moustapha2394/RobotArm/Ressources/HEW-DV4 a lasercut desktop robot arm - 4637503/images/SimpGrip_range_low_res.jpg

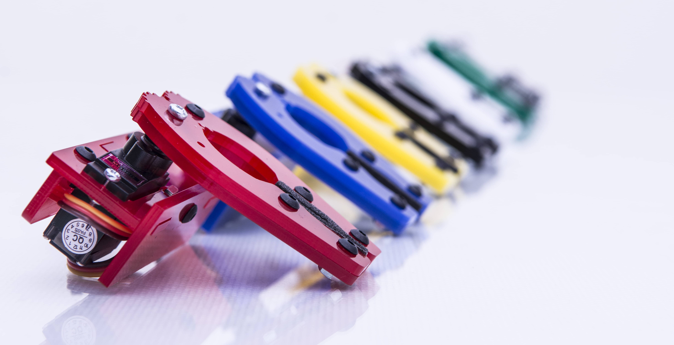
Ressources/HEW-DV4 a lasercut desktop robot arm - 4637503/images/SimpGrip_range_low_res.jpg
