moustapha2394/RobotArm/Ressources/HEW-DV4 a lasercut desktop robot arm - 4637503/images/IMG_1207-min.JPG

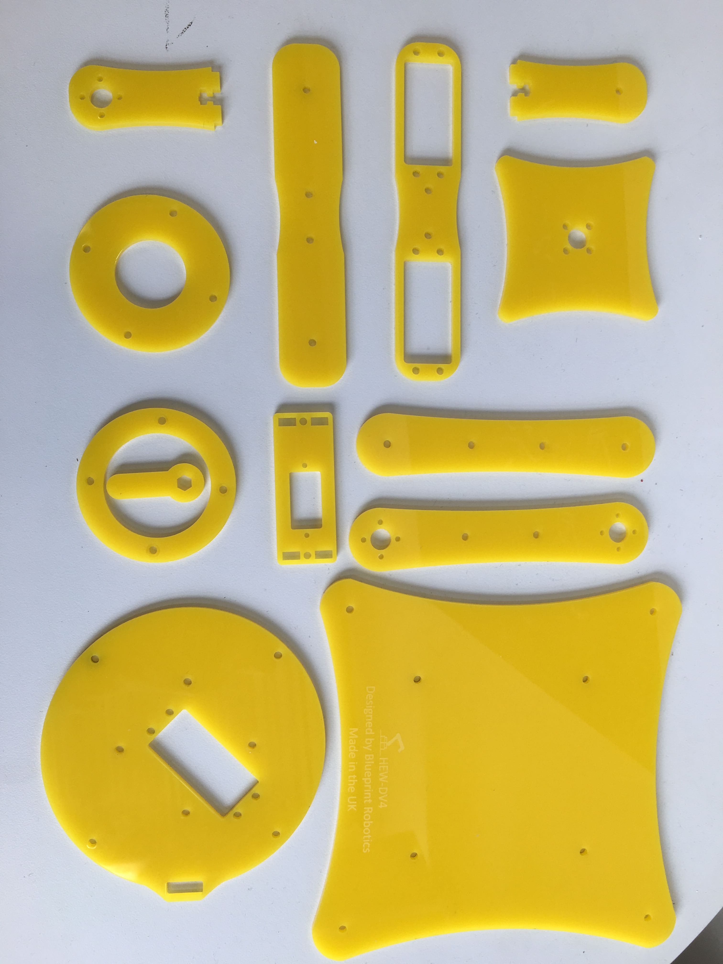
Ressources/HEW-DV4 a lasercut desktop robot arm - 4637503/images/IMG_1207-min.JPG
