moustapha2394/RobotArm/README.md

# RobotArm
Building a robot arm to learn a lot about robots dynamics and programming
