moustapha2394/RobotArm/Ressources/HEW-DV4 a lasercut desktop robot arm - 4637503/README.txt

HEW-DV4 a lasercut desktop robot arm by Nightxp on Thingiverse: https://www.thingiverse.com/thing:4637503
