moustapha2394/RobotArm/Ressources/HEW-DV4 a lasercut desktop robot arm - 4637503/images/PackagingLableBack3.png

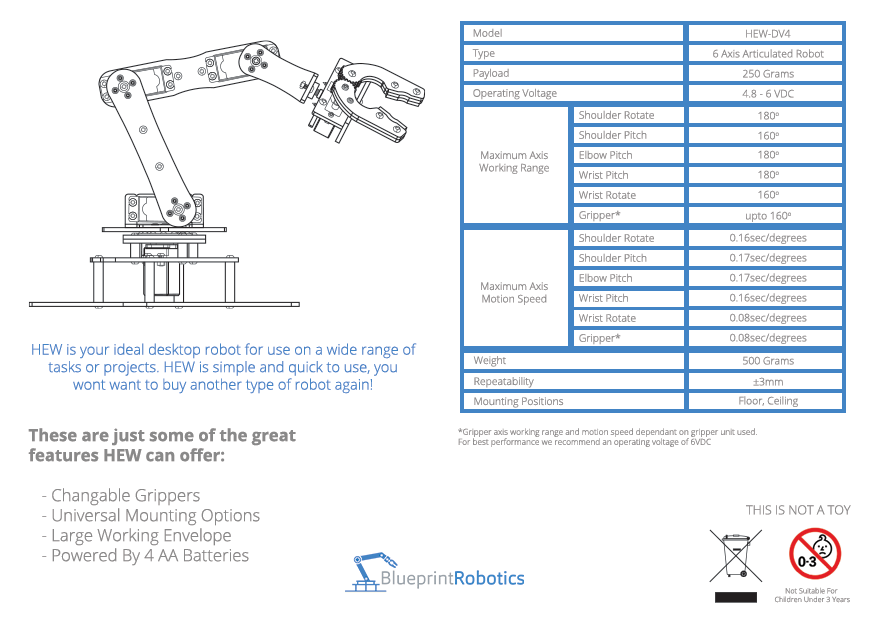
Ressources/HEW-DV4 a lasercut desktop robot arm - 4637503/images/PackagingLableBack3.png
