moustapha2394/RobotArm/Ressources/HEW-DV4 a lasercut desktop robot arm - 4637503/images/Photo_29-08-2016_14_31_16-min.jpg

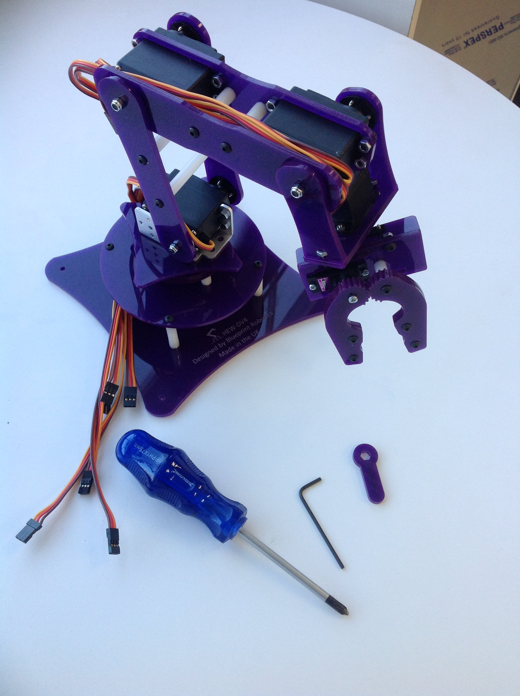
Ressources/HEW-DV4 a lasercut desktop robot arm - 4637503/images/Photo_29-08-2016_14_31_16-min.jpg
