moustapha2394/RobotArm/Ressources/HEW-DV4 a lasercut desktop robot arm - 4637503/files/HEW_3D_print_.STL_parts/HEW .STL parts/hew_dv4-5_p6_wirst_complete.stl

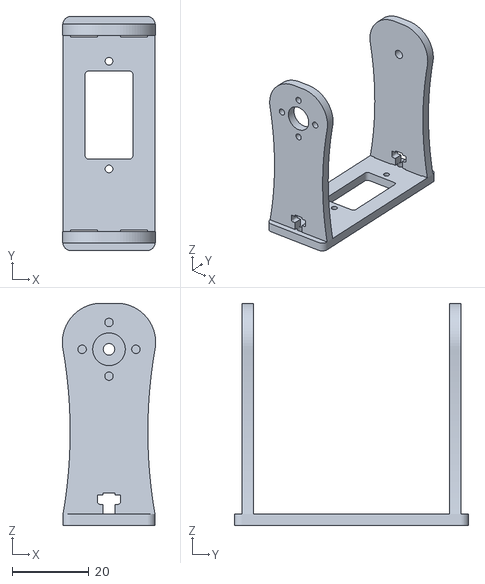
[picture p7: CAD file, 2024-11-22]
Ressources/HEW-DV4 a lasercut desktop robot arm - 4637503/files/HEW_3D_print_.STL_parts/HEW .STL parts/hew_dv4-5_p6_wirst_complete.stl
24.3 x 61.0 x 58.0
