moustapha2394/RobotArm/Ressources/HEW-DV4 a lasercut desktop robot arm - 4637503/files/hew-grippers_flat_file.dxf

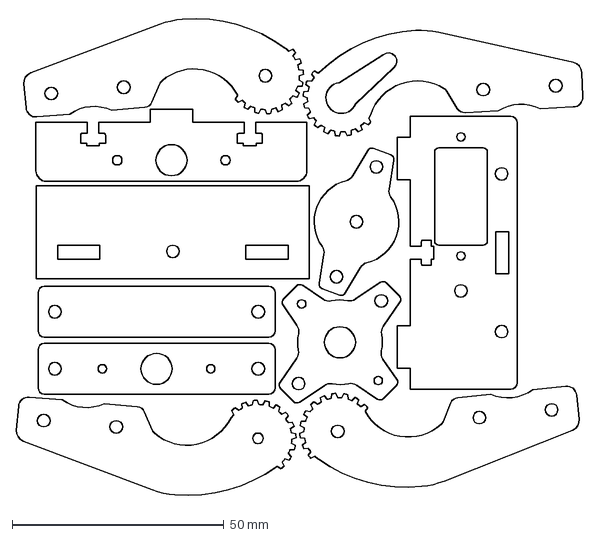
[picture p8: CAD file, 2024-11-22]
Ressources/HEW-DV4 a lasercut desktop robot arm - 4637503/files/hew-grippers_flat_file.dxf
133.9 x 113.8 mm
