moustapha2394/RobotArm/Ressources/HEW-DV4 a lasercut desktop robot arm - 4637503/files/hew-dv4-5_flat_file_mm.dxf

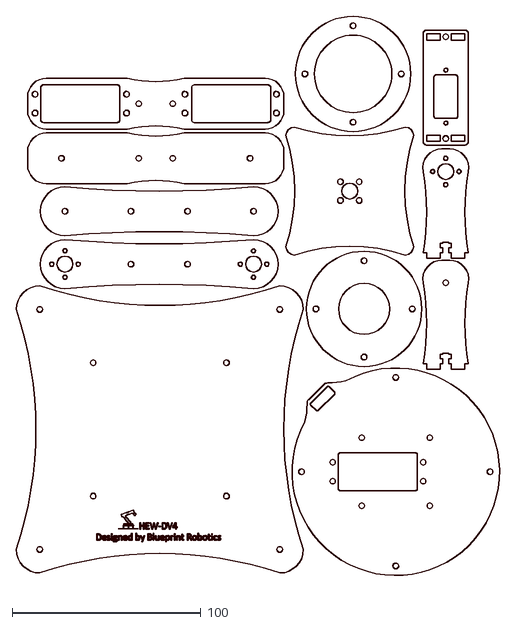
[picture p10: CAD file, 2024-11-22]
Ressources/HEW-DV4 a lasercut desktop robot arm - 4637503/files/hew-dv4-5_flat_file_mm.dxf
261.7 x 301.9
