moustapha2394/RobotArm/Ressources/HEW-DV4 a lasercut desktop robot arm - 4637503/files/HEW_3D_print_.STL_parts/HEW .STL parts/hew_dv4-5_p4_arms.stl

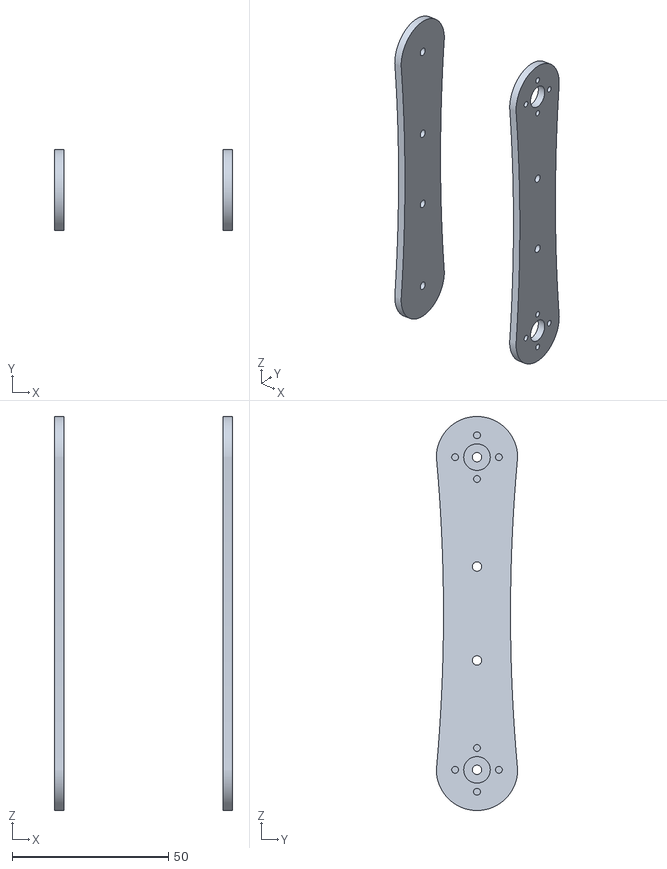
[picture p11: CAD file, 2024-11-22]
Ressources/HEW-DV4 a lasercut desktop robot arm - 4637503/files/HEW_3D_print_.STL_parts/HEW .STL parts/hew_dv4-5_p4_arms.stl
57.0 x 26.0 x 126.0
