moustapha2394/RobotArm/Ressources/HEW-DV4 a lasercut desktop robot arm - 4637503/files/hew-dv4-mg90D_gripper_flat_file.dxf

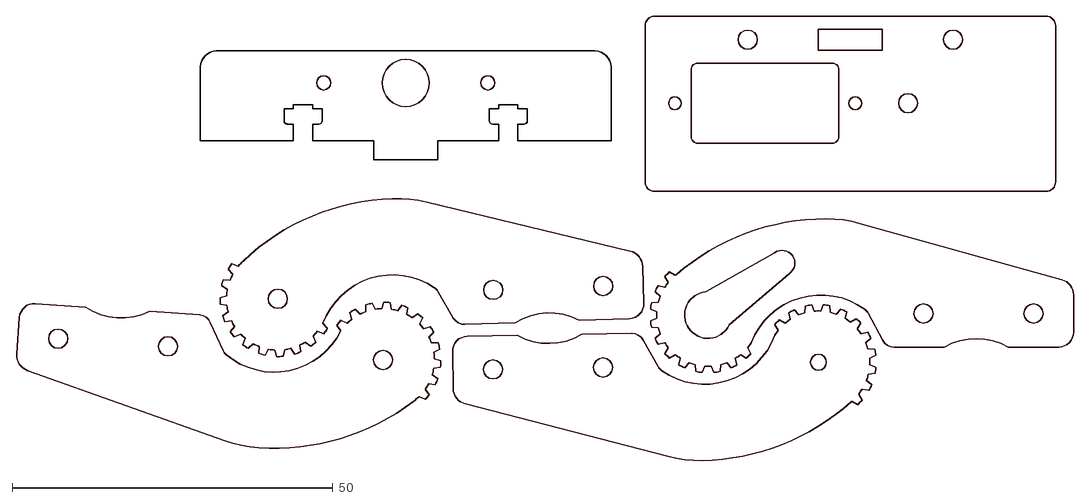
[picture p12: CAD file, 2024-11-22]
Ressources/HEW-DV4 a lasercut desktop robot arm - 4637503/files/hew-dv4-mg90D_gripper_flat_file.dxf
164.8 x 69.3
