moustapha2394/RobotArm/Ressources/HEW-DV4 a lasercut desktop robot arm - 4637503/files/HEW_3D_print_.STL_parts/HEW .STL parts/hew_dv4-5_p2_base_top.stl

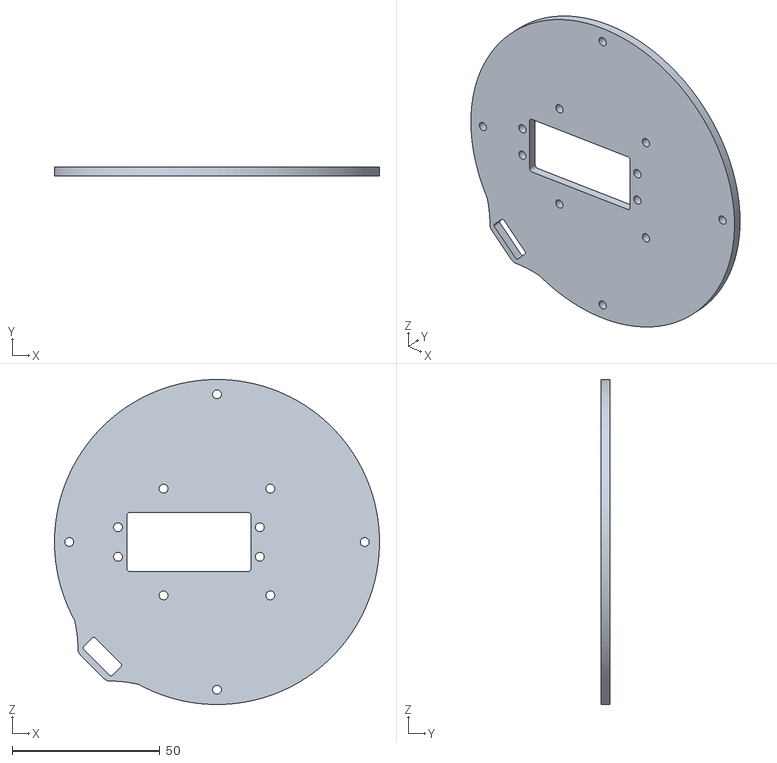
[picture p13: CAD file, 2024-11-22]
Ressources/HEW-DV4 a lasercut desktop robot arm - 4637503/files/HEW_3D_print_.STL_parts/HEW .STL parts/hew_dv4-5_p2_base_top.stl
110.0 x 3.00 x 110.0
