moustapha2394/RobotArm/Ressources/HEW-DV4 a lasercut desktop robot arm - 4637503/files/HEW_3D_print_.STL_parts/HEW .STL parts/hew_dv4-5_p6-3_wrist_top.stl

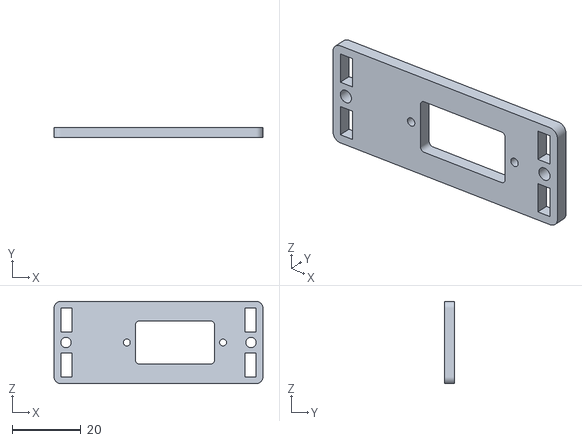
[picture p14: CAD file, 2024-11-22]
Ressources/HEW-DV4 a lasercut desktop robot arm - 4637503/files/HEW_3D_print_.STL_parts/HEW .STL parts/hew_dv4-5_p6-3_wrist_top.stl
61.0 x 3.00 x 24.0
