moustapha2394/RobotArm/Ressources/HEW-DV4 a lasercut desktop robot arm - 4637503/files/Assembly_guide_rev7.1.ForPrint.pdf

# Assembly Guide

# HEW-DV4 robot arm

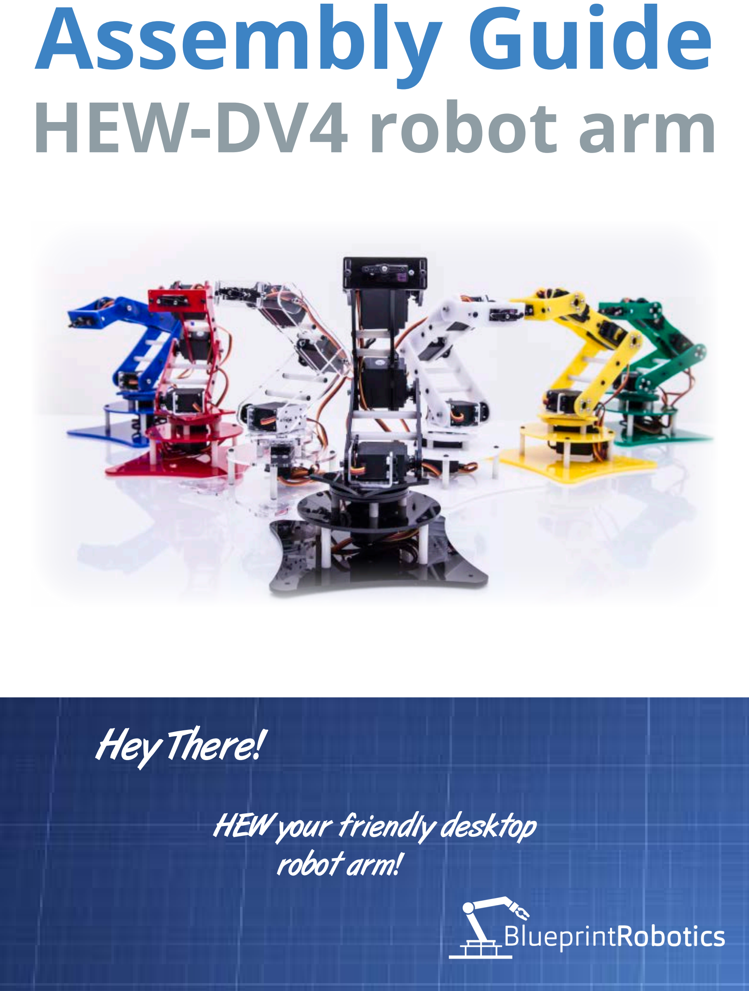
[picture p24: page 1]

# Hey There!

### HEW your friendly desktop robot arm!

Safety & Disclaimer Information

HEW might be a fun gadget to play with but he’s still a machine! Please read all the instructions carefully and take note of all the important information and warnings.

This product is not a toy, follow all warnings and always wear the appropriate PPE (Personal Protective Equipment) when using tools or any other product that could cause harm.

- This product is not suitable for children under three years of age.
- To be used under direct supervision of an adult
- Warning: some parts may have sharp edges.
- For Domestic user only

In no event shall our company be liable for any direct, indirect, punitive, incidental, special consequential damages to property or life arising out of, or connected with, the use or misuse of our products.

Remember Safety First.

Welcome & Thank you!

Hey there nice to meet ‘HEW’ Thank you for purchasing one of our HEW friends, we hope you enjoy using him as much as we do!

This assembly guide will help you build your very own friendly robot arm in just 19 steps! Simply follow this easy-to-use guide through the visual steps and you’ll be ready in no time.

Hand out your own business cards, pick and place ob-jects, play a game of chess or make some music, what will you create?

If you require any support or have any issues regarding our products you can contact us via E-mail at enquiries@blueprintrobotics.co.uk

Thank you & welcome to the world of robotics.

/BlueprintRobotics @BlueprintRobots

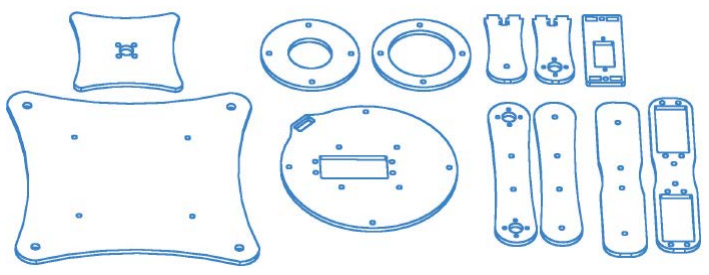
[picture p25: figure]

X4
11mm
Nylon
Standoffs

X2
27.5mm
Nylon
Standoffs

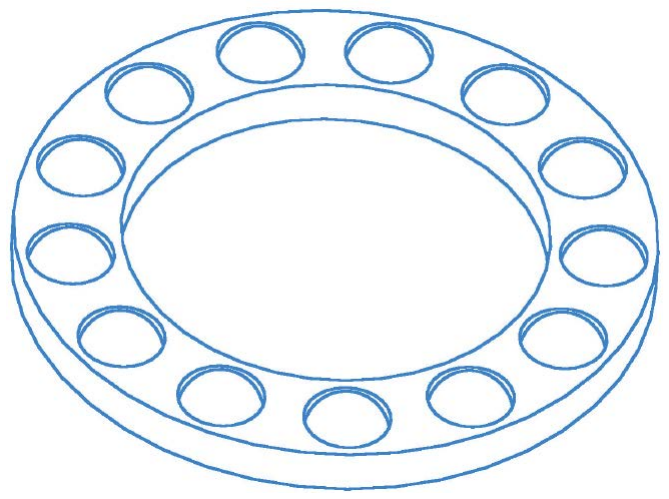
[picture p26: figure]

X4
30mm
Nylon
Standoffs

X2
51mm
Nylon
Standoffs

X1
Aluminium
Servo bracket

X2
M2
Bolt

X2
M2
Nut

X46
M3 x8mm
Button Head
Bolt

X18
M3
Nut

X3
M3
Nylon Locking
Nut

## Parts List

4

5

X1
27.3mm
Thrusy Racer Bearing

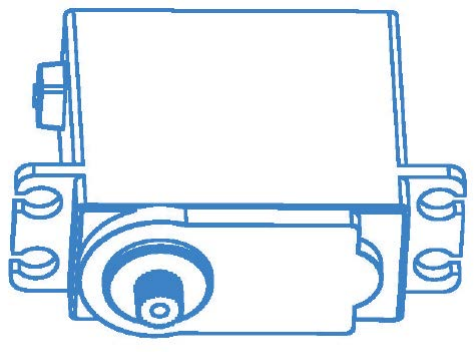
[picture p27: figure]

X2
MG-946
Includes:
Servo Arms & Screws
(Shoulder Servo)

X2
MG-995
Includes:
Servo Arms & Screws
(Base, Elbow & Wrist Pitch)

X1
MG-90D
Includes:
Servo Arms & Screws
(wrist roll servo)

X1
Coloured Acrylic Set

X3
M3 x10mm
Button Head
Bolt

X1
Acrylic Lock
Nut Spanner

Stage 1

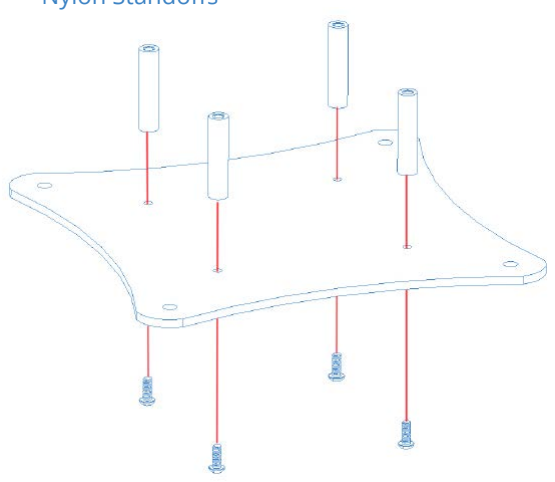
[picture p28: figure]

Stage 2

Stage 3

Stage 4

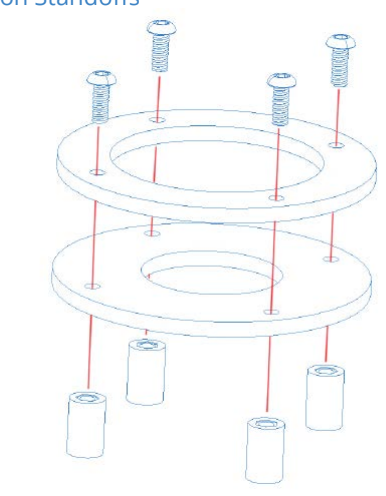
[picture p29: figure]

Bearing should rotate
freely and easily

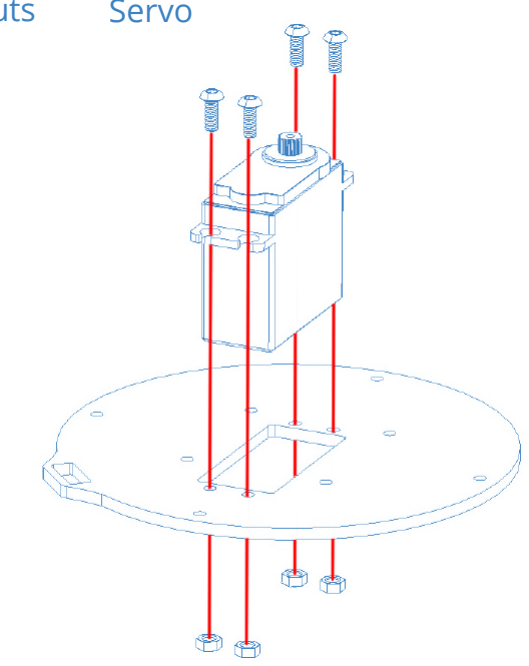
[picture p30: figure]
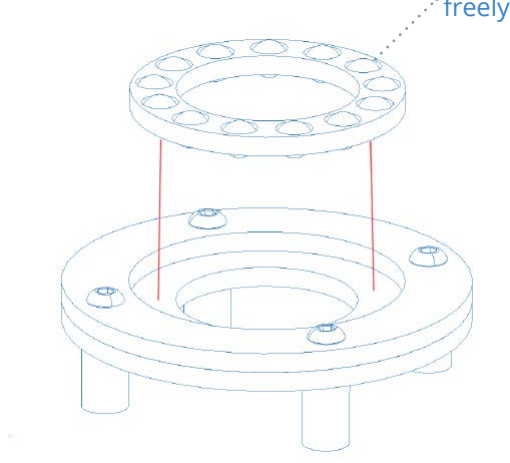
[picture p31: figure]

6 | 7

X4

### 30 mm

Nylon Standoffs

X4
M3 x8mm
Bolts

X4
M3 x8mm
Bolts

X1
MG995
Servo

X4
M3 x8mm
Bolts

X4

### 11 mm

Nylon Standoffs

X4
M3
Nuts

Tip: When mounting the servos loosley fit all bolts before tightening

X1
27.3mm
Thrusy Racer Bearing

Stage 5

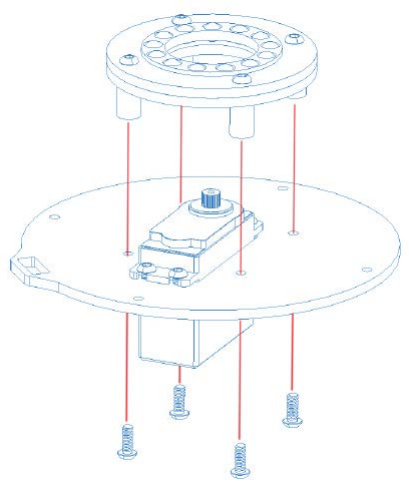
[picture p32: figure]
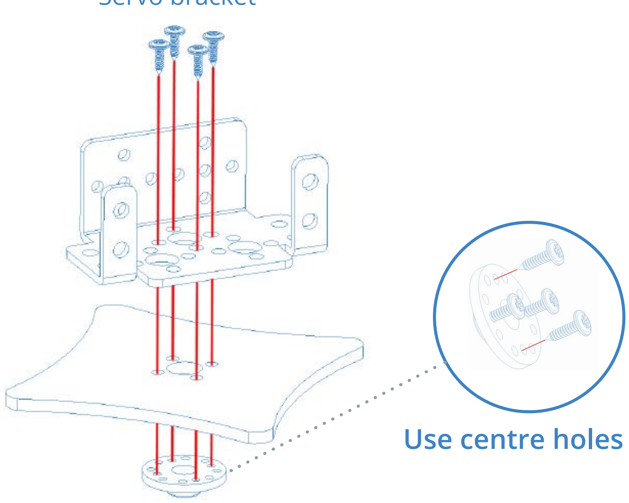
[picture p33: figure]
Use centre holes

Stage 6

Stage 7

Stage 8

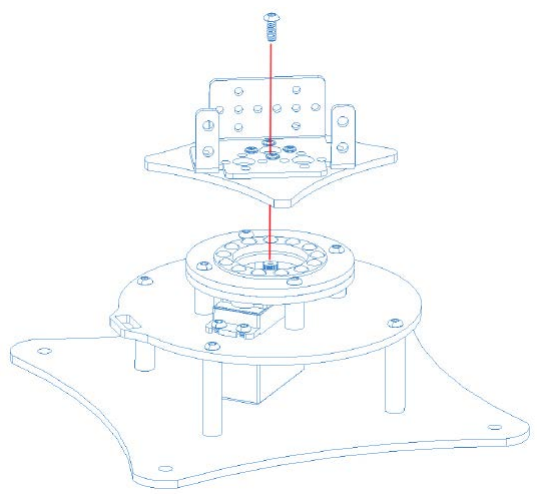
[picture p34: figure]
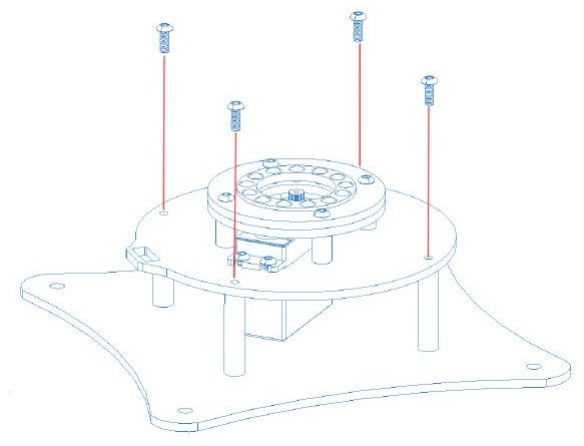
[picture p35: figure]

8 | 9

X4
M3 x8mm
Bolts

X4
M3 x8mm
Bolts

X4
MG995
Screws

X1
M3 x8mm
Bolt

Tip: Do not over tighten, but ensure the platform is flat against the bearings but can rotate easily Set servo to 0 degrees, see page 16

X1
Servo Cam

X1
Aluminium
Servo bracket

Stage 9

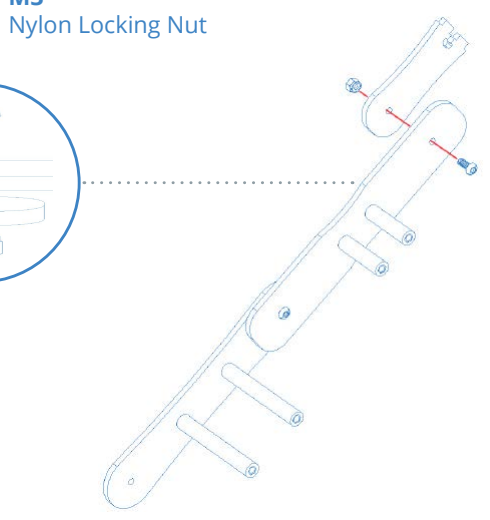
[picture p36: figure]
Nylon Locking Nut
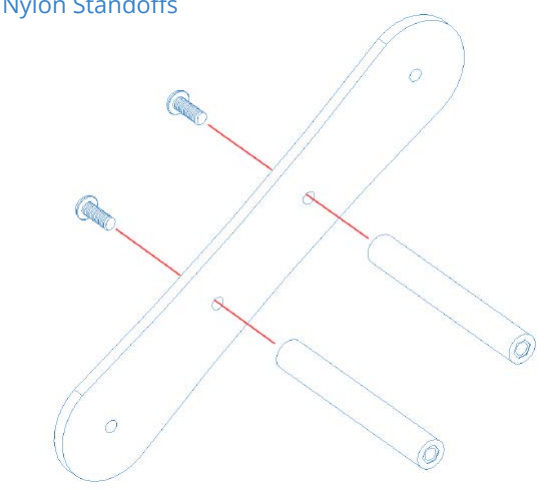
[picture p37: figure]

Stage 10

Stage 11

Stage 12

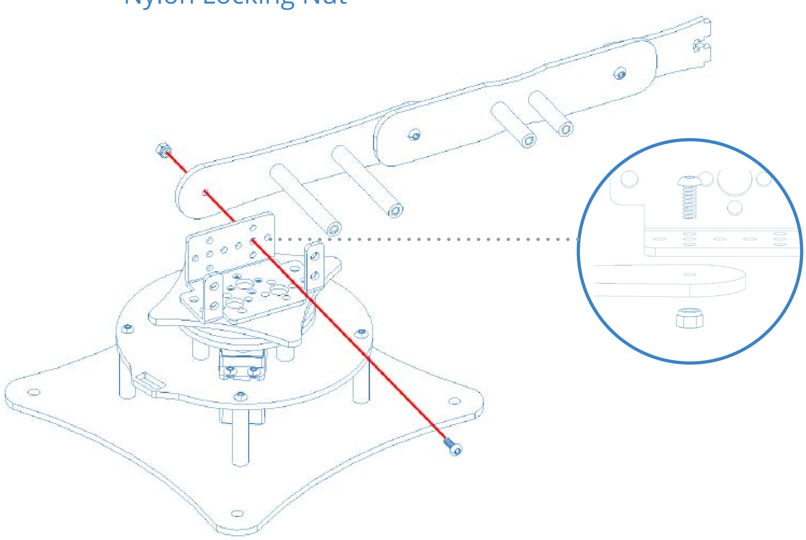
[picture p38: figure]
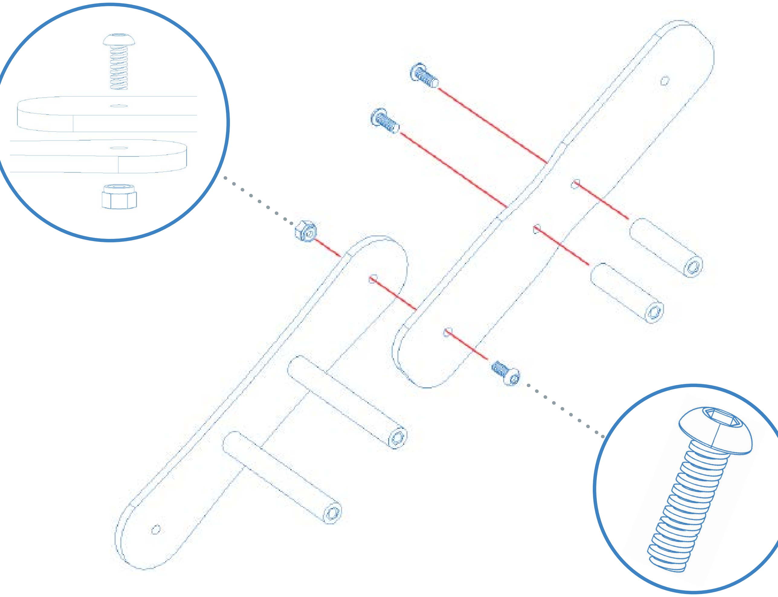
[picture p39: figure]

10 | 11

X2
M3 x8mm
Bolts

X2

### 51 mm

Nylon Standoffs

X2
M3 x8mm
Bolts

X2

### 27.5 mm

Nylon Standoffs

X1
M3
Nylon Locking Nut

X1
M3 x10mm
Bolt

X1
M3

X1
M3 x10mm
Bolt

X1
M3
Nylon Locking Nut

X1
M3 x10mm
Bolts

M3 x10mm Bolt

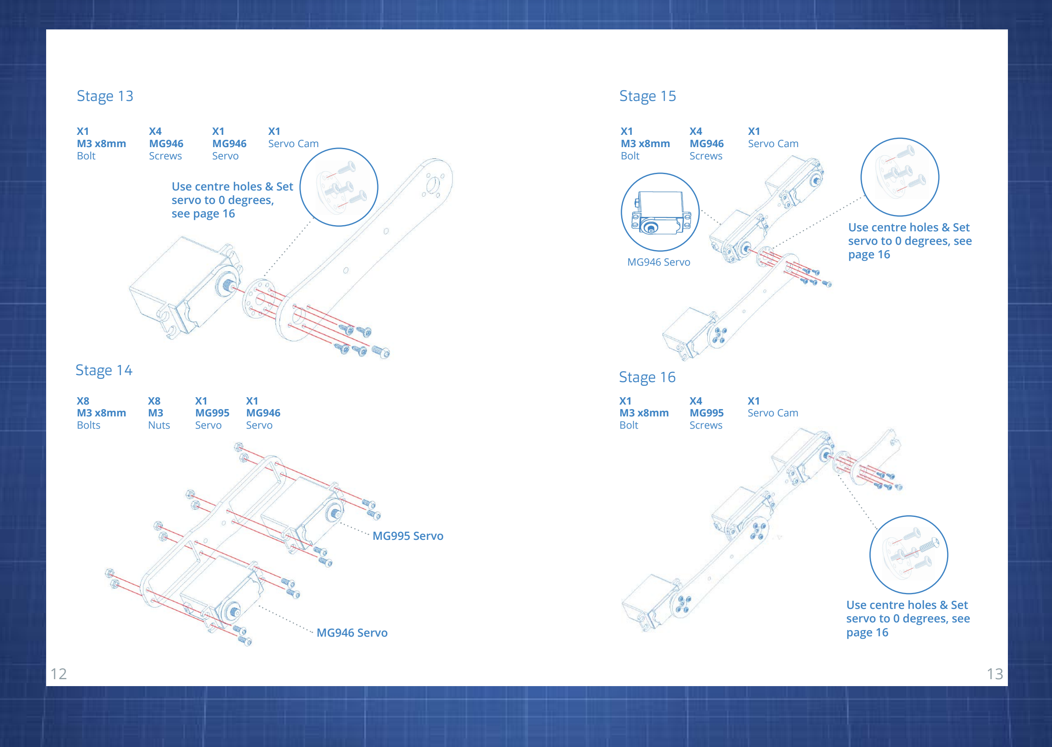
[picture p40: page 7]

Stage 13

Stage 14

Stage 15

Stage 16

Use centre holes & Set
servo to 0 degrees, see
page 16

Use centre holes & Set
servo to 0 degrees,
see page 16

Use centre holes & Set
servo to 0 degrees, see
page 16
12 | 13

X1
M3 x8mm
Bolt

X4
MG946
Screws

X1
MG946
Servo

X8
M3 x8mm
Bolts

X8
M3
Nuts

X1
MG995
Servo

X4
MG946
Screws

X1
M3 x8mm
Bolt

X1
M3 x8mm
Bolt

X4
MG995
Screws

X1
Servo Cam

X1
Servo Cam

X1
Servo Cam

X1
MG946
Servo

MG946 Servo

MG995 Servo

MG946 Servo

Stage 17

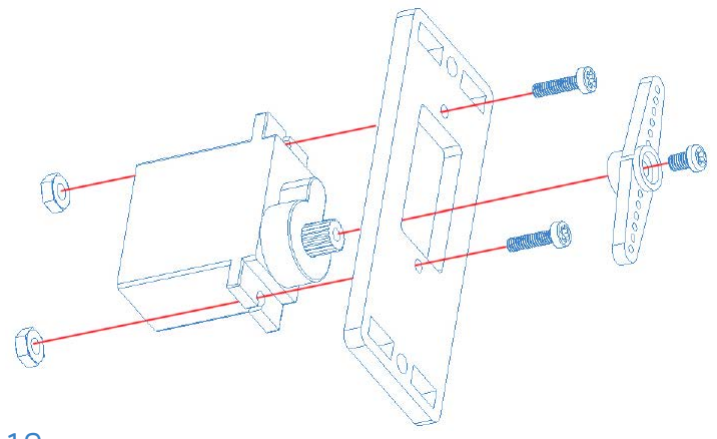
[picture p41: figure]
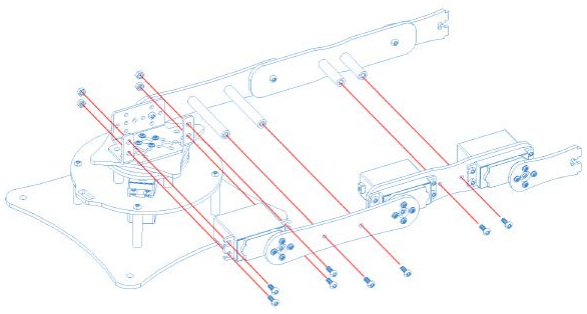
[picture p42: figure]

Stage 19

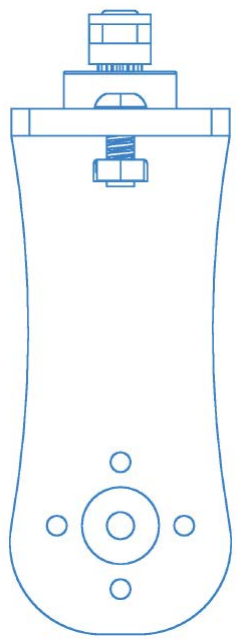
[picture p43: figure]
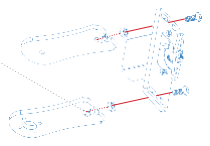
[picture p44: figure]

The nut sits inside the wrist LH & RH plates under a shoulder joint and the M3 bolt is fed through the top plate & between the shoulder joint.

Stage 18

14 | 15

X8
M3 x8mm
Bolts

X4
M3
Nuts

X2
M2
Bolts

X2
M2
Nuts

X1
MG90D
Servo

X1
MG90D
Screw

X2
M3 x8mm
Bolts

X2
M3
Nuts

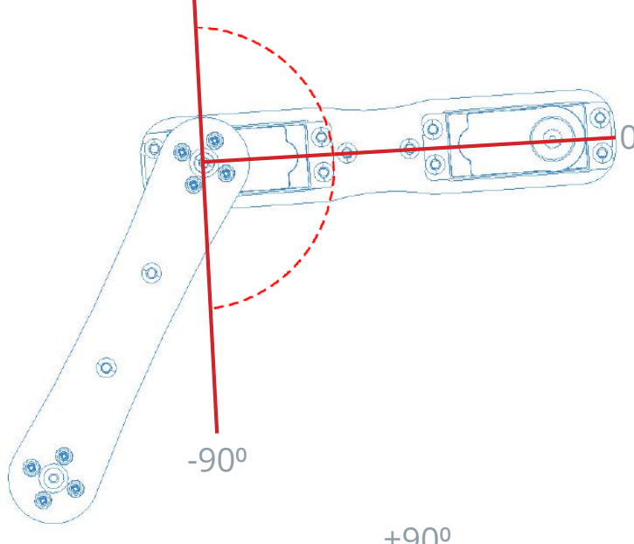
[picture p45: figure]
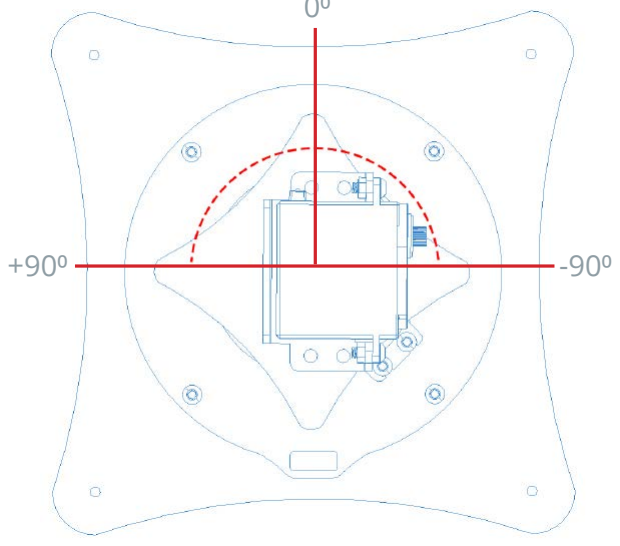
[picture p46: figure]

0⁰

## Servo Range Positions

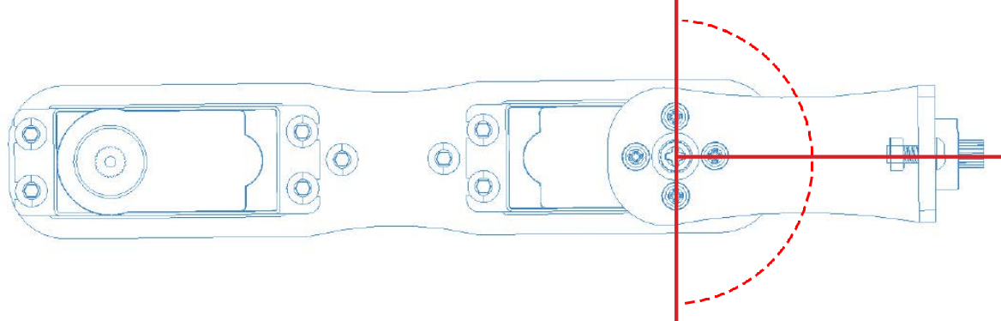
[picture p47: figure]
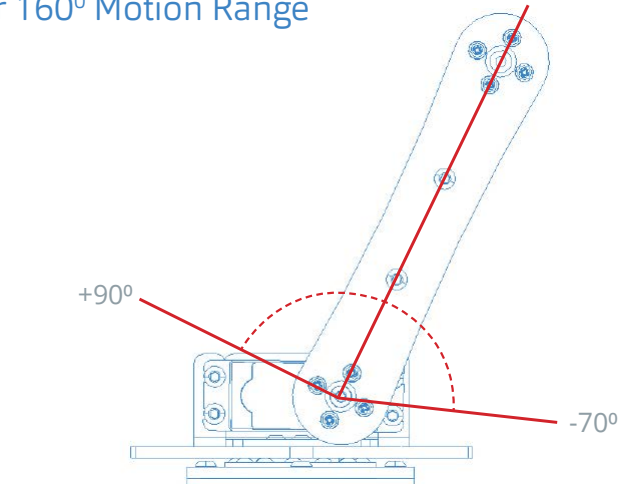
[picture p48: figure]
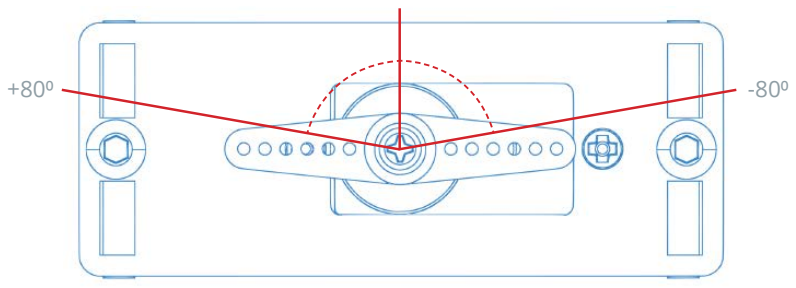
[picture p49: figure]

16 | 17

0⁰

+90⁰

0⁰

0⁰

-90⁰

+90⁰

0⁰

Base 180⁰ Motion Range

Shoulder 160⁰
Motion Range

Elbow 180⁰

Motion Range

Wrist Pitch 180⁰

Motion Range

Wrist Roll 160⁰
Motion Range

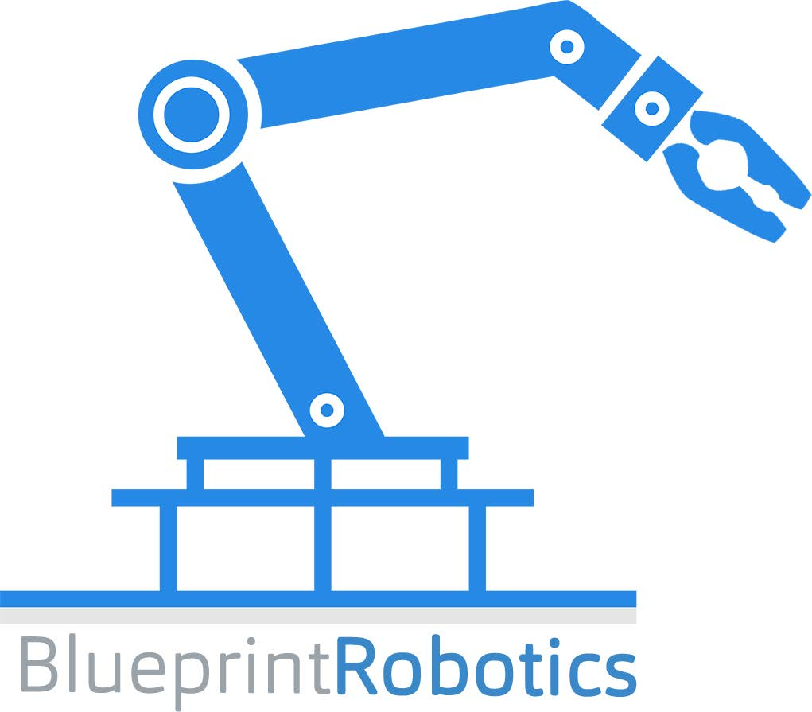
[picture p50: figure]

/BlueprintRobotics @BlueprintRobots

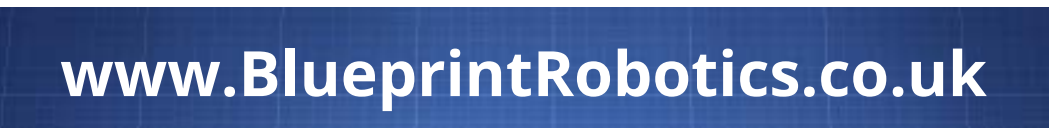
[picture p51: figure]
www.BlueprintRobotics.co.uk
