moustapha2394/RobotArm/(threads)

Thread 1 (2025-02-22):

Missing Grippers

Werterdererste, 2025-02-22:
Hallo,

i plan to build your Robotic arm. But i miss the Grippers.
i found your model on https://www.printables.com/model/443758-hew-desktop-robot-arm
Where you write "Grippers (End Effectors) uploaded into this design now (was going to upload them separate but decided to include them on this design)" But i cant find them on the side ore any were else on the internet.
Can you add them ore send me your files?
