moustapha2394/RobotArm/Ressources/HEW-DV4 a lasercut desktop robot arm - 4637503/files/HEW-DV4_Dimensions__Work_Envolope.pdf

# HEW-DV4

# Dimensions & Work Envelope 152.2

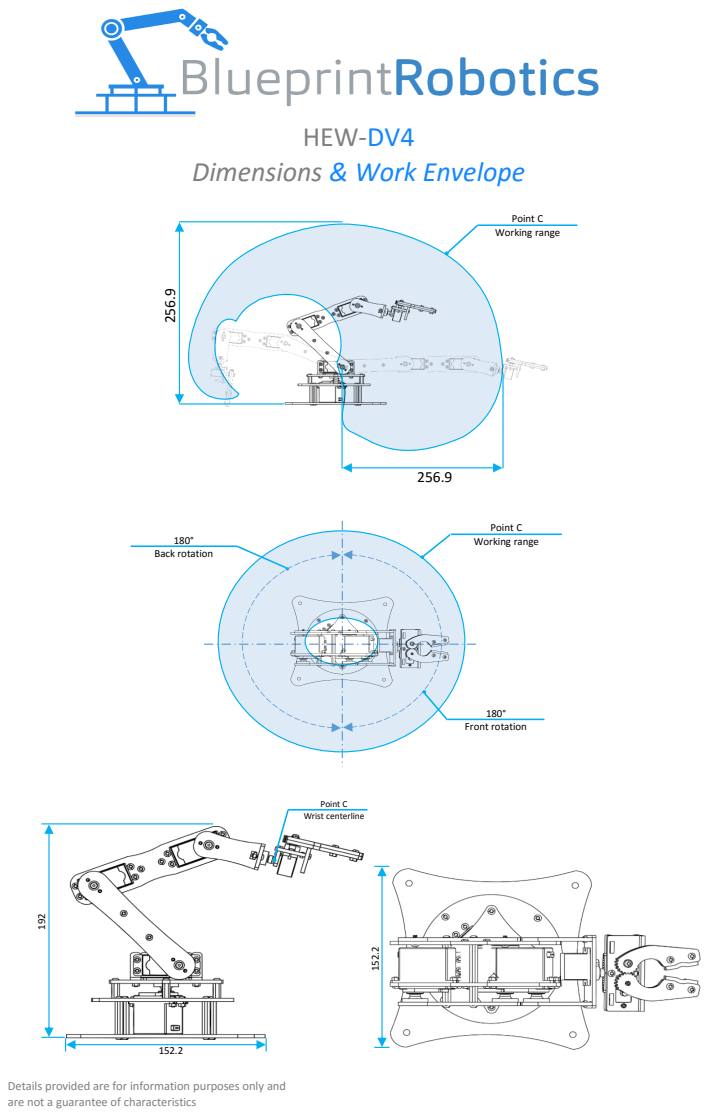
[picture p72: page 1]
Point C Wrist centerline; Point C Working range; 180° Front rotation; Point C; Working range; Back rotation

Details provided are for information purposes only and
are not a guarantee of characteristics

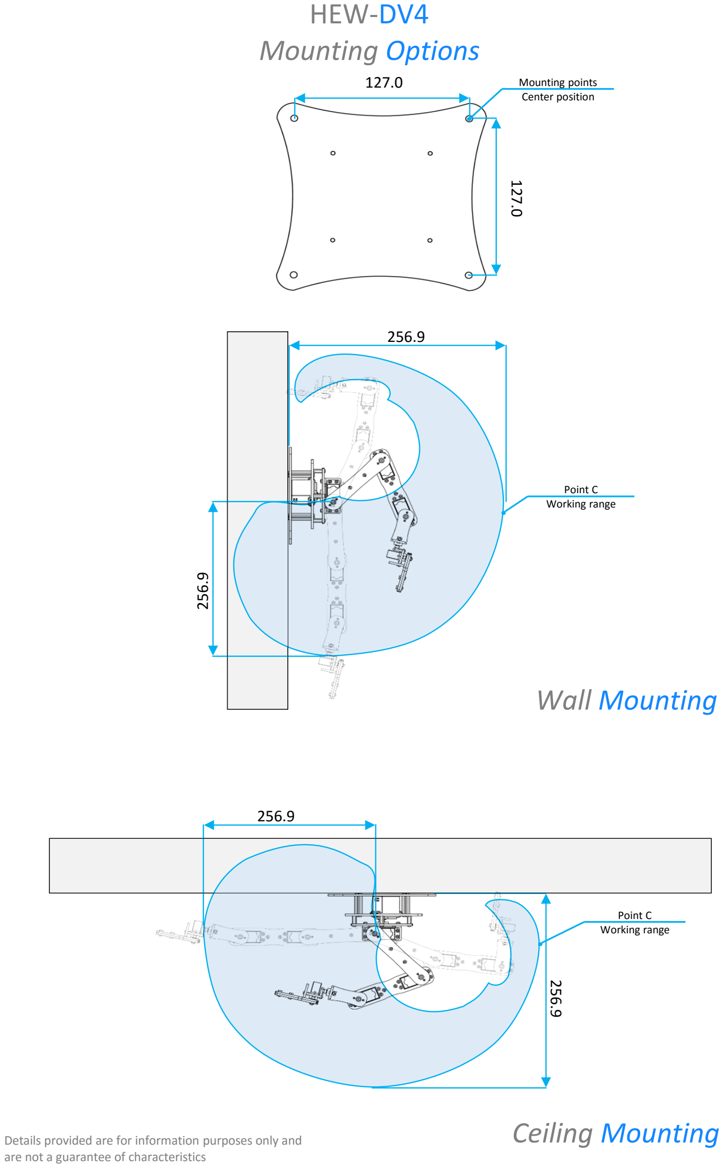
[picture p73: figure]
HEW-DV4 Mounting Options; Mounting points Center position; Point C Working range; Wall Mounting; Ceiling Mounting; are not a guarantee of characteristics

Details provided are for information purposes only and
